Tanvin420/4-Bit_Microprocessor/Microprocessor.PDF

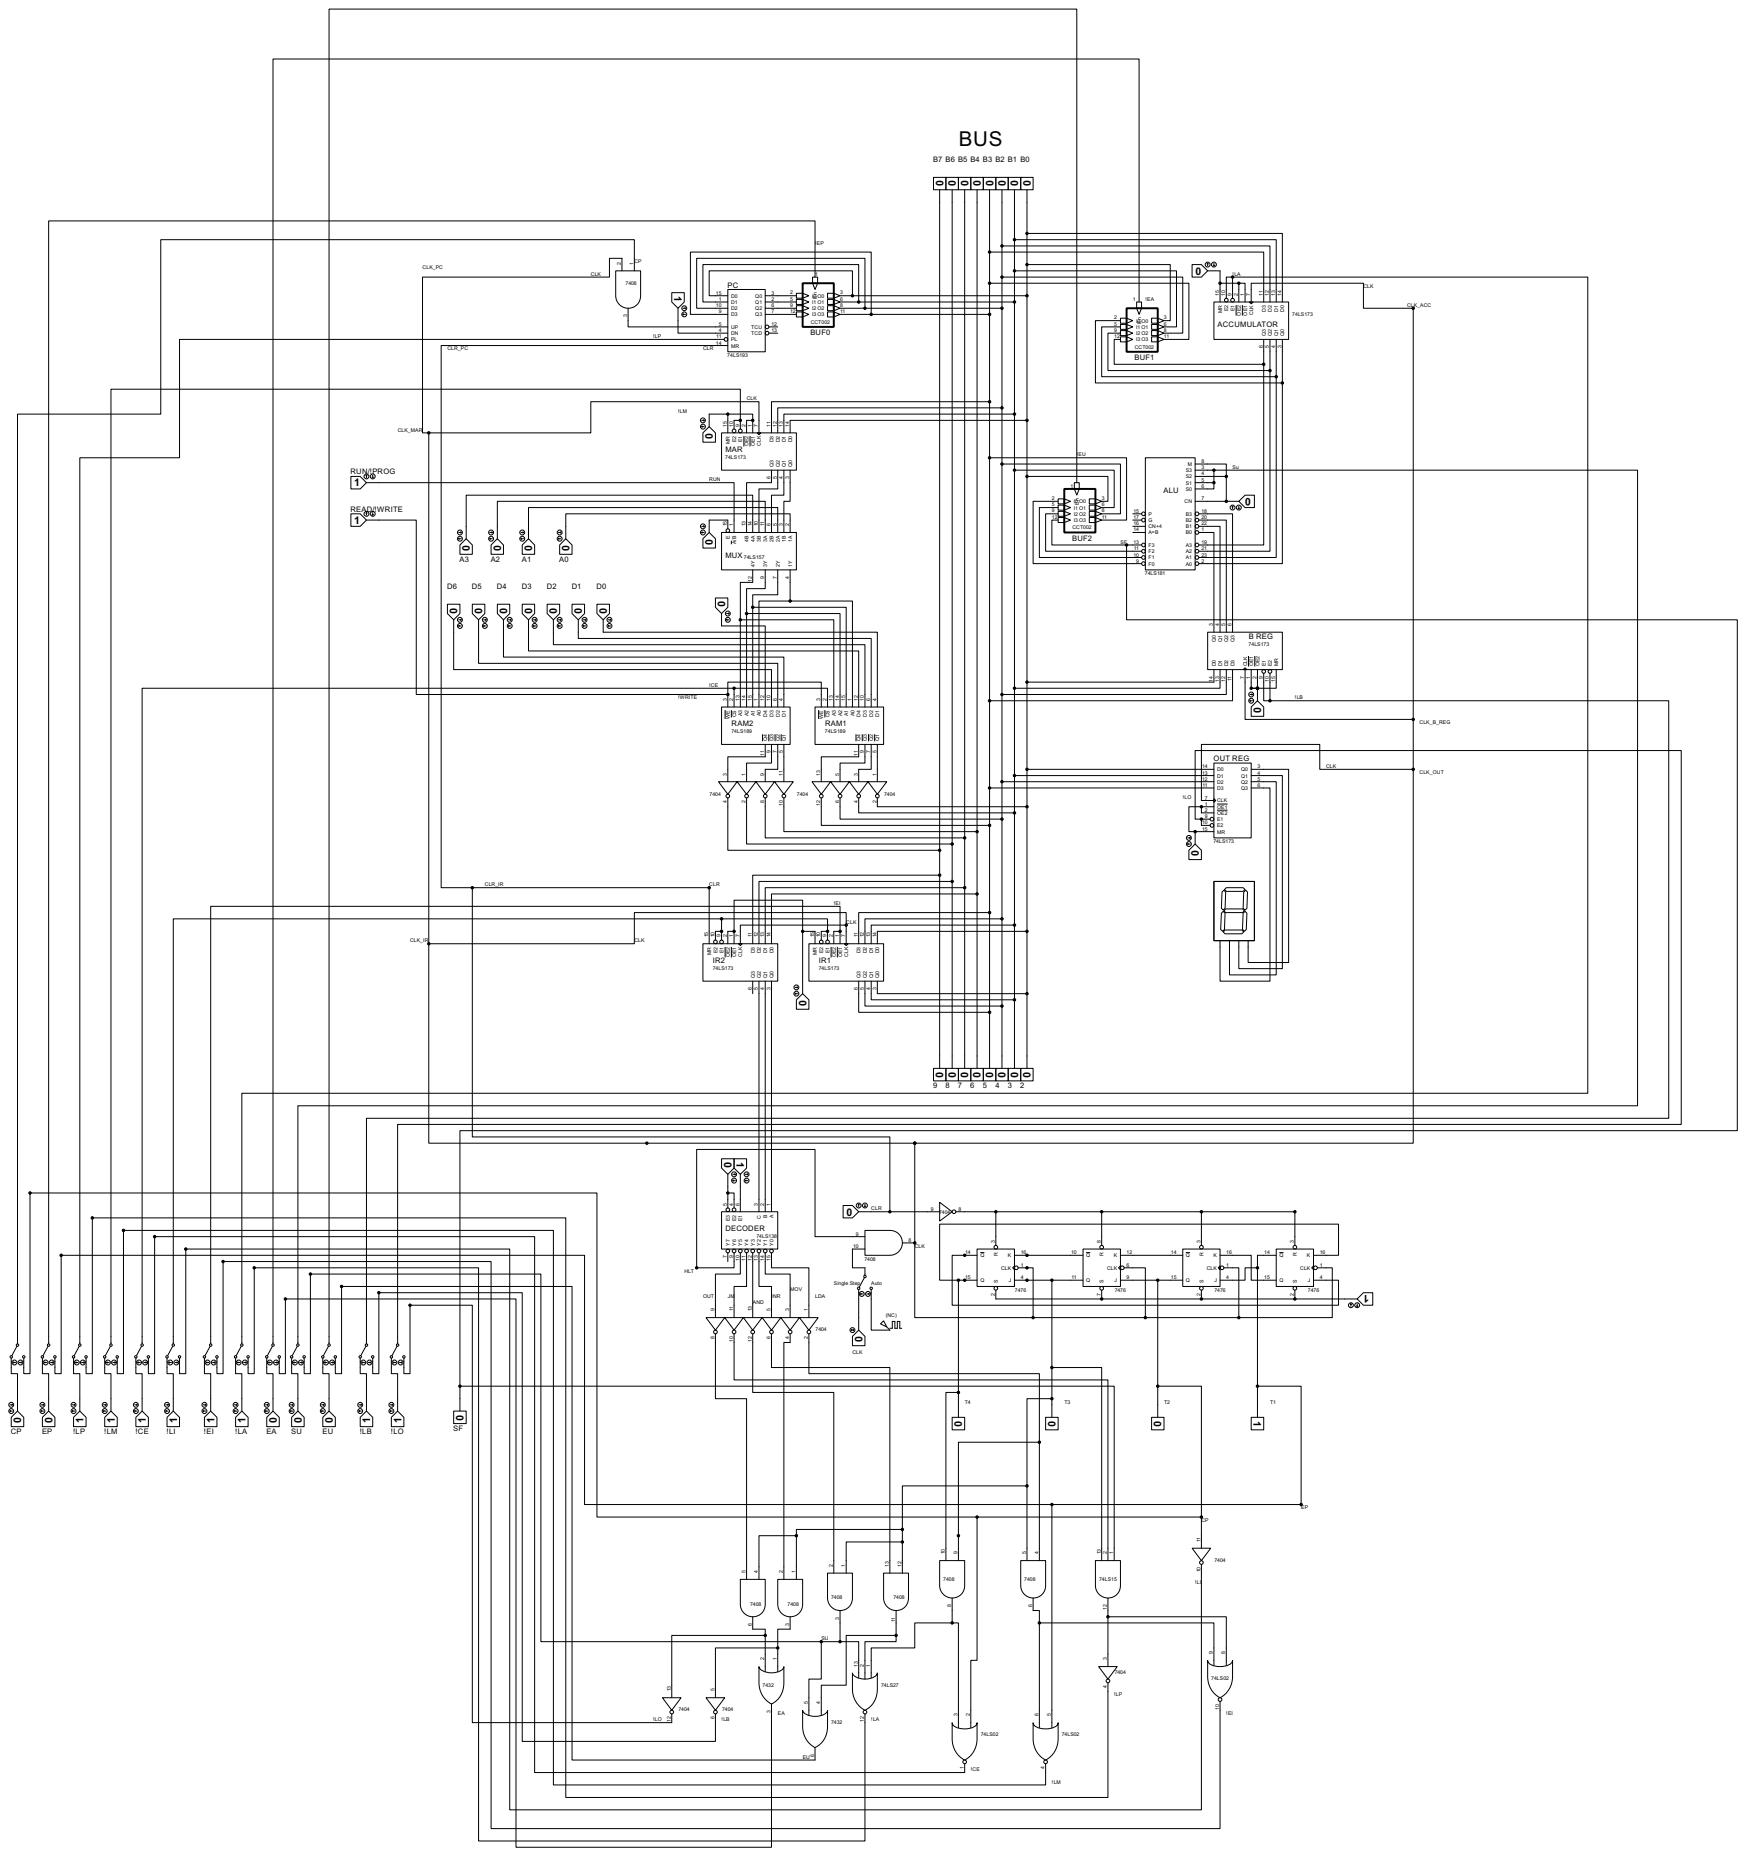
[picture p11: page 1]

5 | I0EO0 I1 | | 6
9 | I2 | O1 O2 O3 | 8

9 | I1 I2 | O0 O1 O2 O3 | 8
5 | I0 | | 6

!WRITE

7404 CLR_IR CLR | 7404 | CLK_B_REG

OUT REG | CLK_OUT

CLK_IR | CLK

CLK

15 | CLK J | 4 Q | 11 | | CLK J | 9 Q | | J | 4 Q
