Tanvin420/4-Bit_Microprocessor/(list of files, drawings)

Other design files:
Microprocessor.pdsprj
